eric5512/TrainingVillage/Documentation/main.pdf

# Training village PCBs documentation

2026-03-03

# 1 Introduction

# The system is comprised of three boards. The main one is a raspberry pi shield, seen in fig 1, which exposes three ethernet connectors that go to the other two boards. It also features a DC connector to power the servos and

other peripherals.


Figure 1: 3D render of the Raspberry Pi shield.

# To control the corridor a PCB is designed, this board has connectors to control the motors, the LED strip, the


Figure 2: 3D render of the corridor PCB.

# The behaviour box is controlled from another board that features one connector for a servo and two connectors for LED strips. This board also

allows to connect IR LEDs with a screwed connector.

1


Figure 3: 3D render of the behaviour box PCB.

# 2 Absolute maximum ratings

# Here is presented a table that summarizes the absolute maximum rating of

the system.

Parameter | Value | Units
Input DC jack voltage | 0-6 | V
Output current | 1 | A

# Table 1: Absolute maximum ratings table

2

# 3 Annex

3

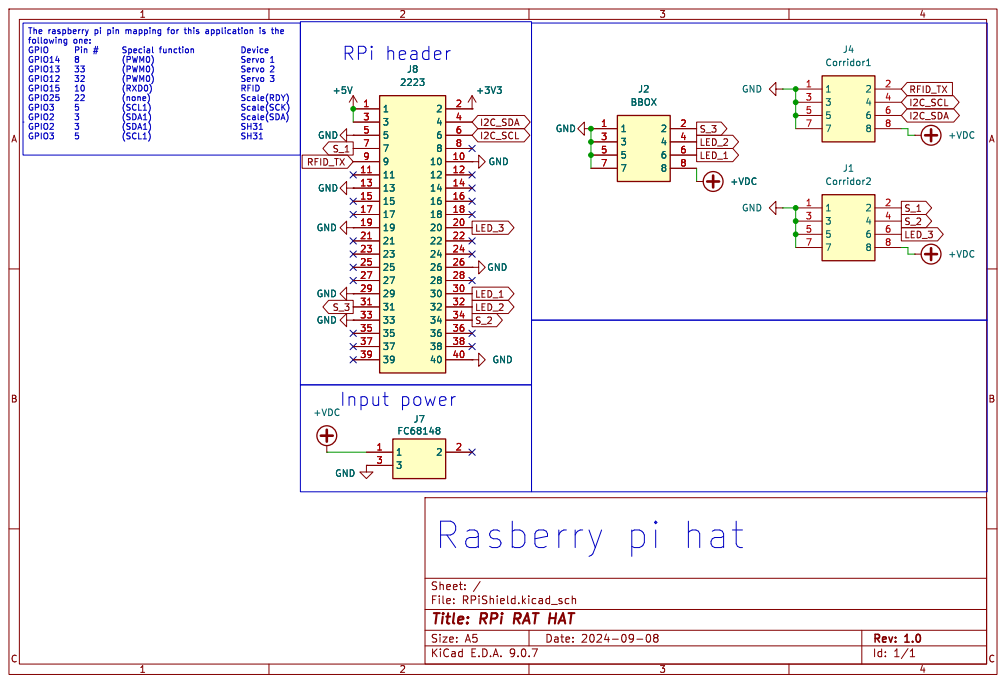
[picture p4: page 5]
Date: 2024-09-08; KiCad; Size: A5; Rev:; File:; RPiShield.kicad_sch; GND; +VDC; J4 Corridor1; J1 Corridor2; J2 BBOX; LED_1; LED_3; I2C_SDA; RFID_TX; I2C_SCL; LED_2; LED_1 RFID_TX; The raspberry; pi pin mapping; for this application; is the; following; one: GPIO Pin; # Special; function Device; GPIO14 8 (PWM0) Servo; 1 GPIO13 33 (PWM0) Servo; 2 GPIO12 32 (PWM0) Servo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

Sheet: /
Title: RPi RAT HAT

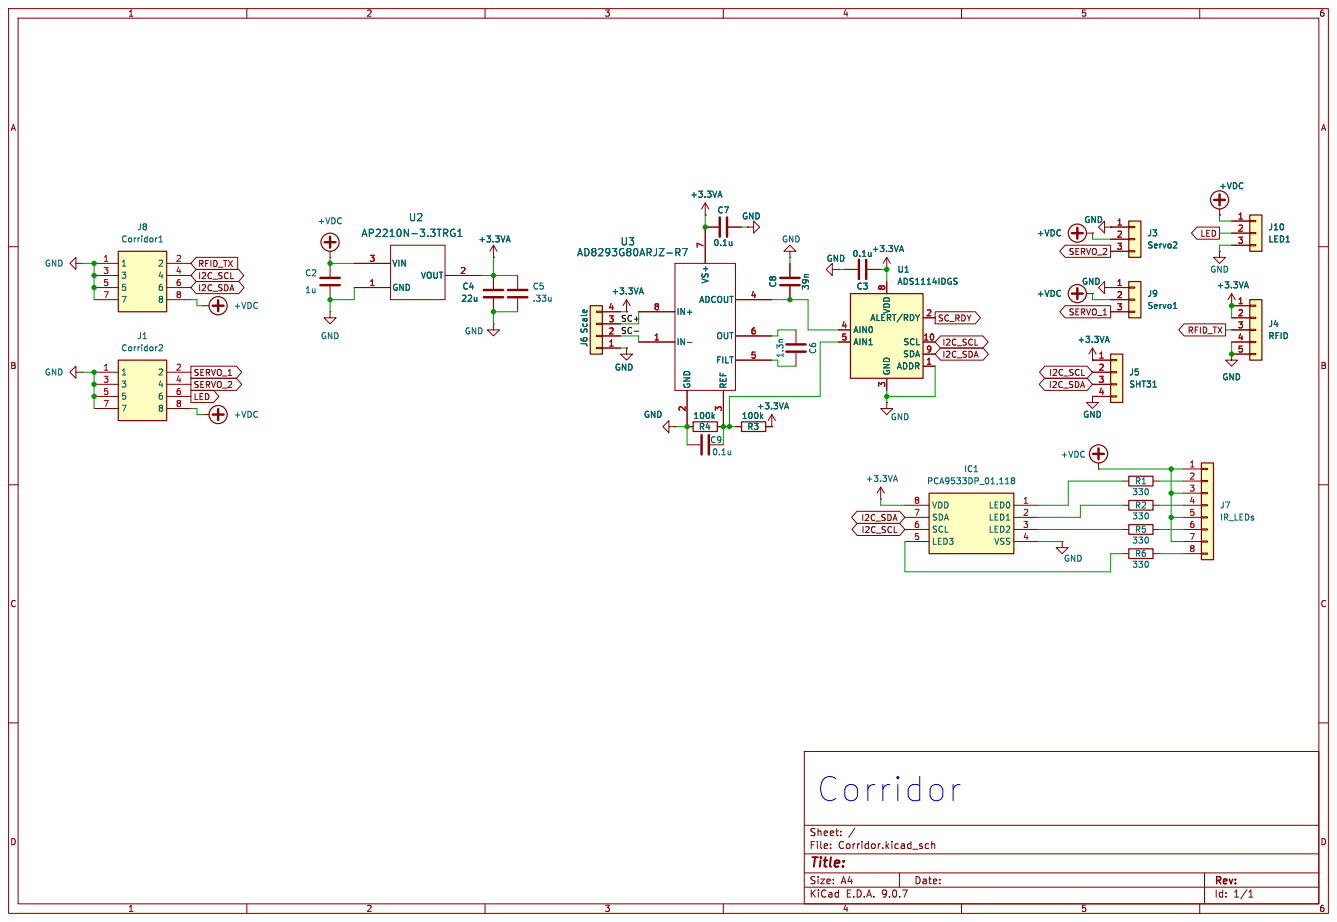
[picture p5: page 6]

3 ADCOUT 4 OUT 6 FILT 5 R4 GND 100k +3.3VA GND

3 ADCOUT 4 OUT 6 FILT 5 U3 AD8293G80ARJZ-R7 GND

3 ALERT/RDY 2 SCL 10 SDA 9 ADDR 1 +3.3VA GND

3 ALERT/RDY 2 SCL 10 SDA 9 ADDR 1 U1ADS1114IDGS

Id: 1/1 Title: File: Corridor.kicad_sch Sheet: /

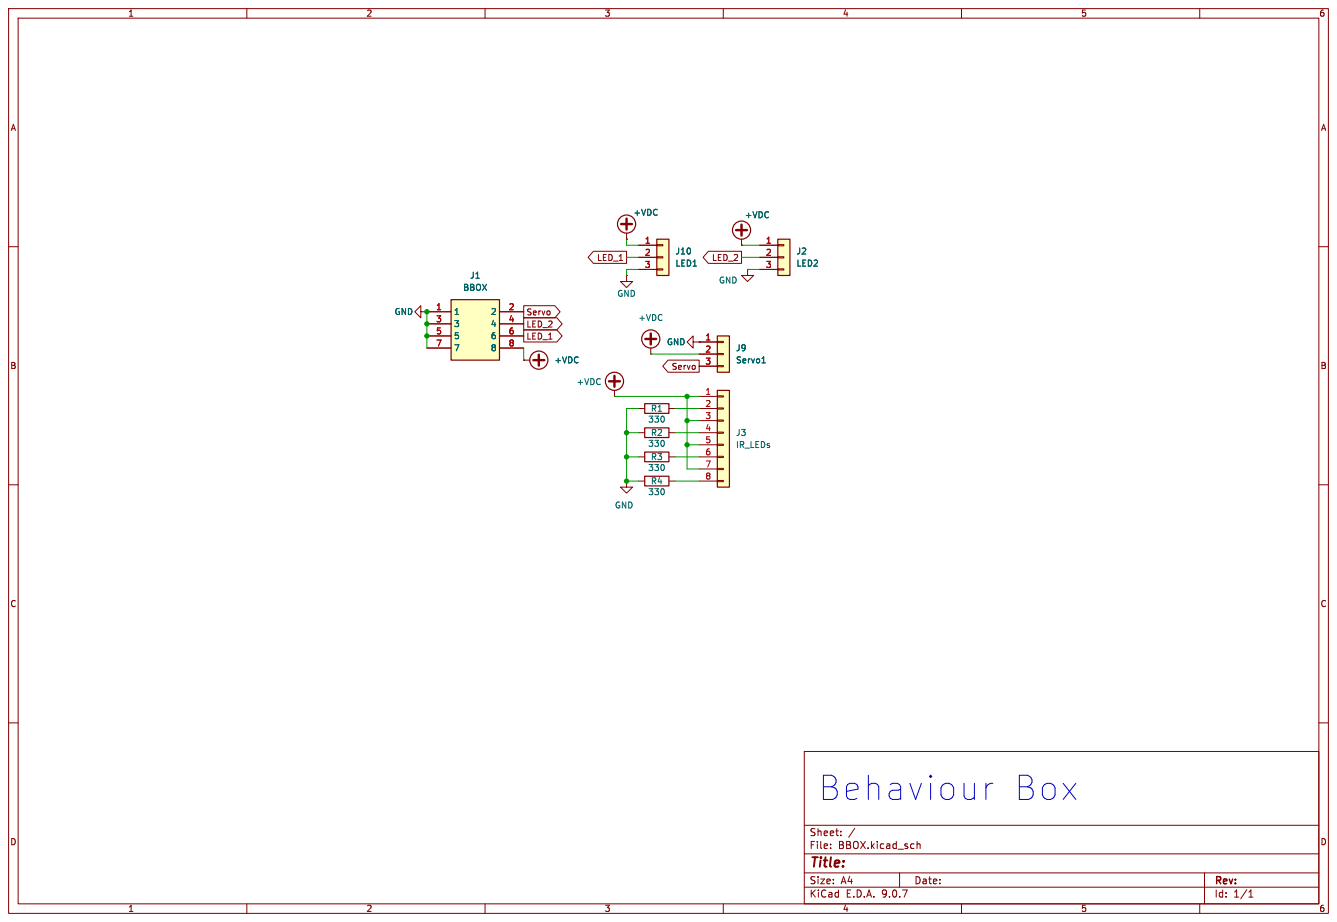
[picture p6: page 7]

Id: 1/1 Title: File: BBOX.kicad_sch Sheet: /
