eric5512/TrainingVillage/BBOX/production_box/production/bom-JLCPCB Assembly Order.xls

JLCPCB BOM Tool - BOM Matching
BOM name：bom-JLCPCB Assembly Order.xlsx |  |  | Download Time：2026-03-19 21:01:40 |  |  |  | * Our matching results are updated in real-time, but stock and prices may change. If it's been over 24 hours, please re-match before placing your order.
PCB Assembled Qty：5 |  |  | Est. Total Price：28.7398
Your BOM |  |  |  |  | Matched Parts |  |  |  |  |  |  | Order Information
Top Designator | Bottom Designator | Comment | Footprint | JLCPCB Part # | Matches | Part # | Manufacturer | Footprint | Description | Category | Warning | JLCPCB Part # | Product link | Lib Type | Qty | Source | Total Price ($)
C2 |  | 1u | 0805 |  | Unconfirmed | CL21B105KBFNNNE | Samsung Electro-Mechanics | 0805 | 1uF 50V X7R ±10% 0805 Multilayer Ceramic Capacitors MLCC - SMD/SMT ROHS | Multilayer Ceramic Capacitors MLCC - SMD/SMT | 1.The comment (CL21B105KBFNNNE) of this part does not match the one (1u) provided in your BOM. Please confirm; | C28323 | https://jlcpcb.com/partdetail/29074-CL21B105KBFNNNE/C28323 | Basic | 5 | 5 JLCPCB | 0.0635
C5 |  | .33u | 0805 |  | Select by Customer | 0805B334K500NT | FH (Guangdong Fenghua Advanced Tech) | 0805 | 330nF 50V X7R ±10% 0805 Multilayer Ceramic Capacitors MLCC - SMD/SMT ROHS | Multilayer Ceramic Capacitors MLCC - SMD/SMT | 1.The comment (0805B334K500NT) of this part does not match the one (.33u) provided in your BOM. Please confirm; | C1740 | https://jlcpcb.com/partdetail/2092-0805B334K500NT/C1740 | Extended | 20 | 20 JLCPCB | 0.31
J1 |  | BBOX | RJ45R08P-A004 |  | Select by Customer | R-RJ45R08P-A004 | Ckmtw(Shenzhen Cankemeng) | 弯插 | 0℃~+70℃ 1 Gold Harpoon Contact (Plastic) Non-LED Phosphor bronze RJ45 Jack Right Angle Unshielded Push-Pull Ethernet Connectors / Modular Connectors (RJ45 RJ11) ROHS | Ethernet Connectors / Modular Connectors (RJ45 RJ11) |  | C385834 | https://jlcpcb.com/partdetail/359709-R_RJ45R08PA004/C385834 | Extended | 5 | 5 JLCPCB | 1.154
J2 |  | WJ127-5.0-2P | WJ127502P |  | Select by Customer | WJ127-5.0-02P-14-00A | Ningbo Kangnex Elec | 插件,P=5mm | -40℃~+105℃ 1 1.5 14~26 15A 1x2P 2 250V 2P 5mm Green Through Hole Plugin,P=5mm Screw Terminal Blocks ROHS | Screw Terminal Blocks |  | C3703 | https://jlcpcb.com/partdetail/4105-WJ127_5_0_02P_1400A/C3703 | Extended | 6 | 6 JLCPCB | 0.9462
J3 |  | Servo2 | PinHeader_1x03_P2.54mm_Vertical |  | Select by Customer | 2.54-1*3P针 | BOOMELE(Boom Precision Elec) | 插件,P=2.54mm | -40℃~+105℃ 1 1x3P 2.54mm 2.5mm 3A 3P 3mm 6mm Black Brass Gold Pin Header Through Hole Plugin,P=2.54mm Pin Headers ROHS | Pin Headers | 1.Multiple lines in the BOM have been matched to the same part. Please check if the matching is correct. ; | C49257 | https://jlcpcb.com/partdetail/50265-2_54_1_3P/C49257 | Extended | 17 | 17 JLCPCB | 0.3451
J9 |  | Servo1 | PinHeader_1x03_P2.54mm_Vertical |  | Select by Customer | 2.54-1*3P针 | BOOMELE(Boom Precision Elec) | 插件,P=2.54mm | -40℃~+105℃ 1 1x3P 2.54mm 2.5mm 3A 3P 3mm 6mm Black Brass Gold Pin Header Through Hole Plugin,P=2.54mm Pin Headers ROHS | Pin Headers | 1.Multiple lines in the BOM have been matched to the same part. Please check if the matching is correct. ; | C49257 | https://jlcpcb.com/partdetail/50265-2_54_1_3P/C49257 | Extended | 17 | 17 JLCPCB | 0.3451
J10 |  | LED | PinHeader_1x03_P2.54mm_Vertical |  | Select by Customer | 2.54-1*3P针 | BOOMELE(Boom Precision Elec) | 插件,P=2.54mm | -40℃~+105℃ 1 1x3P 2.54mm 2.5mm 3A 3P 3mm 6mm Black Brass Gold Pin Header Through Hole Plugin,P=2.54mm Pin Headers ROHS | Pin Headers | 1.Multiple lines in the BOM have been matched to the same part. Please check if the matching is correct. ; | C49257 | https://jlcpcb.com/partdetail/50265-2_54_1_3P/C49257 | Extended | 17 | 17 JLCPCB | 0.3451
J7 |  | IR_LEDs | JL500_8 |  | Select by Customer | JL500-50008GT1 | JILN | 插件,P=5mm | -40℃~+105℃ 1 14~26 15A 1x8P 300V 5mm 8 8P Green M2.5 Through Hole Plugin,P=5mm Screw Terminal Blocks ROHS | Screw Terminal Blocks |  | C2802622 | https://jlcpcb.com/partdetail/JILN-JL50050008GT1/C2802622 | Extended | 5 | 5 JLCPCB | 2.662
Q1 |  | IRLML2502PBF | SOT95P237X112-3N |  | Unconfirmed | IRLML2502PBF-HXY | HXY MOSFET | SOT-23 | -55℃~+150℃ 1 N-channel 1.25W 15nC@4.5V 1V 20V 27mΩ@4.5V 295pF 500pF 96pF 9A N-Channel SOT-23 MOSFETs ROHS | MOSFETs | 1.The comment (IRLML2502PBF-HXY) of this part does not match the one (IRLML2502PBF) provided in your BOM. Please confirm; | C22366704 | https://jlcpcb.com/partdetail/HXYMOSFET-IRLML2502PBFHXY/C22366704 | Extended | 5 | 5 JLCPCB | 0.584
R1,R2,R5,R6 |  | 330 | 1206 |  | Unconfirmed | FRC1206J331 TS | FOJAN | 1206 | -55℃~+155℃ 200V 250mW 330Ω Thick Film Resistor ±100ppm/℃ ±5% 1206 Chip Resistor - Surface Mount ROHS | Chip Resistor - Surface Mount | 1.The comment (FRC1206J331 TS) of this part does not match the one (330) provided in your BOM. Please confirm; | C2907482 | https://jlcpcb.com/partdetail/FOJAN-FRC1206J331TS/C2907482 | Extended | 30 | 30 JLCPCB | 0.084
R7,R8 |  | 4.7k | 0805 |  | Unconfirmed | 0805W8F4701T5E | UNI-ROYAL(Uniroyal Elec) | 0805 | -55℃~+155℃ 125mW 150V 4.7kΩ Thick Film Resistor ±1% ±100ppm/℃ 0805 Chip Resistor - Surface Mount ROHS | Chip Resistor - Surface Mount | 1.The comment (0805W8F4701T5E) of this part does not match the one (4.7k) provided in your BOM. Please confirm; | C17673 | https://jlcpcb.com/partdetail/18361-0805W8F4701T5E/C17673 | Basic | 10 | 10 JLCPCB | 0.019
R9 |  | 10 | 0805 |  | Unconfirmed | 0805W8F100JT5E | UNI-ROYAL(Uniroyal Elec) | 0805 | -55℃~+155℃ 10Ω 125mW 150V Thick Film Resistor ±1% ±200ppm/℃ 0805 Chip Resistor - Surface Mount ROHS | Chip Resistor - Surface Mount | 1.The comment (0805W8F100JT5E) of this part does not match the one (10) provided in your BOM. Please confirm; | C17415 | https://jlcpcb.com/partdetail/18103-0805W8F100JT5E/C17415 | Basic | 5 | 5 JLCPCB | 0.012
U2 |  | AP2210N-3.3TRG1 | SOT_3.3TRG1_DIO |  | Select by System | AP2210N-3.3TRG1 | Diodes Incorporated | SOT-23 | -40℃~+125℃@(Tj) 1 13.2V 1uA 250mV@(300mA) 3.3V 300mA 75dB@(100Hz) Fixed Over Current Protection、Over Temperature Protection Positive SOT-23 Voltage Regulators - Linear, Low Drop Out (LDO) Regulators ROHS | Voltage Regulators - Linear, Low Drop Out (LDO) Regulators |  | C155508 | https://jlcpcb.com/partdetail/DiodesIncorporated-AP2210N_33TRG1/C155508 | Extended | 7 | 7 JLCPCB | 0.8988
U4 |  | PCA9685PW | TSSOP-28_4.4x9.7mm_P0.65mm |  | Unconfirmed | PCA9685PW,118 | NXP Semicon | TSSOP-28 | -40℃~+85℃ 100kHz~1MHz 16 2.3V~5.5V 25mA 5.5V Built-in PWM TSSOP-28 LED Drivers ROHS | LED Drivers | 1.The comment (PCA9685PW,118) of this part does not match the one (PCA9685PW) provided in your BOM. Please confirm; | C2678753 | https://jlcpcb.com/partdetail/NXPSemicon-PCA9685PW118/C2678753 | Extended | 5 | 5 JLCPCB | 18.594
U5 |  | PCA9306 | VSSOP-8_2.3x2mm_P0.5mm |  | Unconfirmed | PCA9306DC1Z | NXP Semicon | VSSOP-8 | -40℃~+105℃ 1 1.8V~5.5V 1V~3.6V 2 2Mbps Auto Direction Detection Bidirectional Open Drain VSSOP-8 Translators, Level Shifters ROHS | Translators, Level Shifters | 1.The comment (PCA9306DC1Z) of this part does not match the one (PCA9306) provided in your BOM. Please confirm; | C5119911 | https://jlcpcb.com/partdetail/NXPSemicon-PCA9306DC1Z/C5119911 | Extended | 5 | 5 JLCPCB | 2.377
C4 |  | 22u | C_Elec_5x5.8 |  | No matches | No Part Selected
