eric5512/TrainingVillage/Corridor/production_corridor/production/bom-JLCPCB Assembly Order.xls

JLCPCB BOM Tool - BOM Matching
BOM name：bom-JLCPCB Assembly Order.xlsx |  |  | Download Time：2026-03-19 20:32:50 |  |  |  | * Our matching results are updated in real-time, but stock and prices may change. If it's been over 24 hours, please re-match before placing your order.
PCB Assembled Qty：5 |  |  | Est. Total Price：122.1937
Your BOM |  |  |  |  | Matched Parts |  |  |  |  |  |  | Order Information
Top Designator | Bottom Designator | Comment | Footprint | JLCPCB Part # | Matches | Part # | Manufacturer | Footprint | Description | Category | Warning | JLCPCB Part # | Product link | Lib Type | Qty | Source | Total Price ($)
C2 |  | 1u | 1206 |  | Unconfirmed | CL31B105KBHNNNE | Samsung Electro-Mechanics | 1206 | 1uF 50V X7R ±10% 1206 Multilayer Ceramic Capacitors MLCC - SMD/SMT ROHS | Multilayer Ceramic Capacitors MLCC - SMD/SMT | 1.The comment (CL31B105KBHNNNE) of this part does not match the one (1u) provided in your BOM. Please confirm; | C1848 | https://jlcpcb.com/partdetail/2200-CL31B105KBHNNNE/C1848 | Basic | 5 | 5 JLCPCB | 0.139
C3,C7,C9 |  | 0.1u | 1206 |  | Unconfirmed | CL31B104KBCNNNC | Samsung Electro-Mechanics | 1206 | 100nF 50V X7R ±10% 1206 Multilayer Ceramic Capacitors MLCC - SMD/SMT ROHS | Multilayer Ceramic Capacitors MLCC - SMD/SMT | 1.The comment (CL31B104KBCNNNC) of this part does not match the one (0.1u) provided in your BOM. Please confirm; | C24497 | https://jlcpcb.com/partdetail/25237-CL31B104KBCNNNC/C24497 | Basic | 15 | 15 JLCPCB | 0.2295
C6 |  | 1.3n | 1206 |  | Select by Customer | 1206B152K500NT | FH (Guangdong Fenghua Advanced Tech) | 1206 | 1.5nF 50V X7R ±10% 1206 Multilayer Ceramic Capacitors MLCC - SMD/SMT ROHS | Multilayer Ceramic Capacitors MLCC - SMD/SMT |  | C1851 | https://jlcpcb.com/partdetail/2203-1206B152K500NT/C1851 | Extended | 15 | 15 JLCPCB | 0.21
C8 |  | 39n | 1206 |  | Unconfirmed | GRM3195C1H393JA01D | Murata Electronics | 1206 | 39nF 50V C0G ±5% 1206 Multilayer Ceramic Capacitors MLCC - SMD/SMT ROHS | Multilayer Ceramic Capacitors MLCC - SMD/SMT | 1.The comment (GRM3195C1H393JA01D) of this part does not match the one (39n) provided in your BOM. Please confirm; | C119053 | https://jlcpcb.com/partdetail/120322-GRM3195C1H393JA01D/C119053 | Extended | 7 | 7 JLCPCB | 0.84
IC2 |  | SHT31-DIS-B2.5KS | SON50P250X250X100-9N-D |  | Select by System | SHT31-DIS-B2.5kS | Sensirion | DFN-8-EP(2.5x2.5) | -40℃~+125℃ 0%RH~100%RH 2.15V~5.5V 600uA I2C ±0.2℃ ±2%RH DFN-8-EP(2.5x2.5) Temperature and Humidity Sensor ROHS | Temperature And Humidity Sensor |  | C80862 | https://jlcpcb.com/partdetail/Sensirion-SHT31_DIS_B25kS/C80862 | Extended | 5 | 5 JLCPCB | 23.7675
J1 |  | WJ127-5.0-2P | WJ127502P |  | Select by Customer | WJ127-5.0-02P-14-00A | Ningbo Kangnex Elec | 插件,P=5mm | -40℃~+105℃ 1 1.5 14~26 15A 1x2P 2 250V 2P 5mm Green Through Hole Plugin,P=5mm Screw Terminal Blocks ROHS | Screw Terminal Blocks |  | C3703 | https://jlcpcb.com/partdetail/4105-WJ127_5_0_02P_1400A/C3703 | Extended | 6 | 6 JLCPCB | 0.9462
J3 |  | Servo2 | PinHeader_1x03_P2.54mm_Vertical |  | Select by Customer | 2.54-1*3P针 | BOOMELE(Boom Precision Elec) | 插件,P=2.54mm | -40℃~+105℃ 1 1x3P 2.54mm 2.5mm 3A 3P 3mm 6mm Black Brass Gold Pin Header Through Hole Plugin,P=2.54mm Pin Headers ROHS | Pin Headers | 1.Multiple lines in the BOM have been matched to the same part. Please check if the matching is correct. ; | C49257 | https://jlcpcb.com/partdetail/50265-2_54_1_3P/C49257 | Extended | 12 | 12 JLCPCB | 0.2436
J9 |  | Servo1 | PinHeader_1x03_P2.54mm_Vertical |  | Select by Customer | 2.54-1*3P针 | BOOMELE(Boom Precision Elec) | 插件,P=2.54mm | -40℃~+105℃ 1 1x3P 2.54mm 2.5mm 3A 3P 3mm 6mm Black Brass Gold Pin Header Through Hole Plugin,P=2.54mm Pin Headers ROHS | Pin Headers | 1.Multiple lines in the BOM have been matched to the same part. Please check if the matching is correct. ; | C49257 | https://jlcpcb.com/partdetail/50265-2_54_1_3P/C49257 | Extended | 12 | 12 JLCPCB | 0.2436
J4 |  | RFID | JST_PH_B5B-PH-K_1x05_P2.00mm_Vertical |  | Select by Customer | B5B-PH-K-S(LF)(SN) | JST | 插件,P=2mm | -25℃~+85℃ 1 100V 11.9mm 1x5P 2A 2mm 4.5mm 5 5P 6mm Brass K Pin PA66 PH Through Hole Tin UL94V-0 White Plugin,P=2mm Wire To Board Connector ROHS | Wire To Board Connector |  | C157993 | https://jlcpcb.com/partdetail/JST-B5B_PH_K_S_LF_SN/C157993 | Extended | 5 | 5 JLCPCB | 0.2655
J6 |  | Scale | JL308-25404G01 |  | Select by Customer | JL308-25404G01 | JILN | 插件,P=2.54mm | -40℃~+105℃ 1 150V 18~26 1x4P 2.54mm 4 4P 6A Green M2.5 Through Hole 插件,P=2.54mm Screw Terminal Blocks ROHS | Screw Terminal Blocks |  | C2922599 | https://jlcpcb.com/partdetail/JILN-JL30825404G01/C2922599 | Extended | 5 | 5 JLCPCB | 2.2265
J7 |  | IR_LEDs | JL500_8 |  | Select by Customer | JL500-50008GT1 | JILN | 插件,P=5mm | -40℃~+105℃ 1 14~26 15A 1x8P 300V 5mm 8 8P Green M2.5 Through Hole Plugin,P=5mm Screw Terminal Blocks ROHS | Screw Terminal Blocks |  | C2802622 | https://jlcpcb.com/partdetail/JILN-JL50050008GT1/C2802622 | Extended | 5 | 5 JLCPCB | 2.662
J8 |  | Corridor1 | RJ45R08P-A004 |  | Select by Customer | R-RJ45R08P-A004 | Ckmtw(Shenzhen Cankemeng) | 弯插 | 0℃~+70℃ 1 Gold Harpoon Contact (Plastic) Non-LED Phosphor bronze RJ45 Jack Right Angle Unshielded Push-Pull Ethernet Connectors / Modular Connectors (RJ45 RJ11) ROHS | Ethernet Connectors / Modular Connectors (RJ45 RJ11) |  | C385834 | https://jlcpcb.com/partdetail/359709-R_RJ45R08PA004/C385834 | Extended | 5 | 5 JLCPCB | 1.154
Q1 |  | IRLML2502PBF | SOT95P237X112-3N |  | Unconfirmed | IRLML2502PBF-HXY | HXY MOSFET | SOT-23 | -55℃~+150℃ 1 N-channel 1.25W 15nC@4.5V 1V 20V 27mΩ@4.5V 295pF 500pF 96pF 9A N-Channel SOT-23 MOSFETs ROHS | MOSFETs | 1.The comment (IRLML2502PBF-HXY) of this part does not match the one (IRLML2502PBF) provided in your BOM. Please confirm; | C22366704 | https://jlcpcb.com/partdetail/HXYMOSFET-IRLML2502PBFHXY/C22366704 | Extended | 5 | 5 JLCPCB | 0.584
R1,R2,R5,R6 |  | 330 | 1206 |  | Unconfirmed | FRC1206J331 TS | FOJAN | 1206 | -55℃~+155℃ 200V 250mW 330Ω Thick Film Resistor ±100ppm/℃ ±5% 1206 Chip Resistor - Surface Mount ROHS | Chip Resistor - Surface Mount | 1.The comment (FRC1206J331 TS) of this part does not match the one (330) provided in your BOM. Please confirm; | C2907482 | https://jlcpcb.com/partdetail/FOJAN-FRC1206J331TS/C2907482 | Extended | 30 | 30 JLCPCB | 0.084
R3,R4 |  | 100k | 1206 |  | Unconfirmed | 1206W4F1003T5E | UNI-ROYAL(Uniroyal Elec) | 1206 | -55℃~+155℃ 100kΩ 200V 250mW Thick Film Resistor ±1% ±100ppm/℃ 1206 Chip Resistor - Surface Mount ROHS | Chip Resistor - Surface Mount | 1.The comment (1206W4F1003T5E) of this part does not match the one (100k) provided in your BOM. Please confirm; | C17900 | https://jlcpcb.com/partdetail/18588-1206W4F1003T5E/C17900 | Basic | 10 | 10 JLCPCB | 0.044
R7,R8 |  | 4.7k | 0805 |  | Unconfirmed | 0805W8F4701T5E | UNI-ROYAL(Uniroyal Elec) | 0805 | -55℃~+155℃ 125mW 150V 4.7kΩ Thick Film Resistor ±1% ±100ppm/℃ 0805 Chip Resistor - Surface Mount ROHS | Chip Resistor - Surface Mount | 1.The comment (0805W8F4701T5E) of this part does not match the one (4.7k) provided in your BOM. Please confirm; | C17673 | https://jlcpcb.com/partdetail/18361-0805W8F4701T5E/C17673 | Basic | 10 | 10 JLCPCB | 0.019
R9 |  | 10 | 1206 |  | Unconfirmed | 1206W4F100JT5E | UNI-ROYAL(Uniroyal Elec) | 1206 | -55℃~+155℃ 10Ω 200V 250mW Thick Film Resistor ±1% ±400ppm/℃ 1206 Chip Resistor - Surface Mount ROHS | Chip Resistor - Surface Mount | 1.The comment (1206W4F100JT5E) of this part does not match the one (10) provided in your BOM. Please confirm; | C17903 | https://jlcpcb.com/partdetail/18591-1206W4F100JT5E/C17903 | Basic | 5 | 5 JLCPCB | 0.0175
U1 |  | ADS1114IDGS | DGS10 |  | Select by Customer | ADS1114IDGSR | Texas Instruments | VSSOP-10 | -40℃~+125℃ 1 150uA 16 1LSB 1MHz 2V~5.5V 6.144V 8Hz 8Hz、16Hz、32Hz、64Hz、128Hz、250Hz、475Hz、860Hz Built-in Built-in I2C Sigma-Delta Support Yes VSSOP-10 Analog to Digital Converters (ADC) ROHS | Analog To Digital Converters (ADC) |  | C174291 | https://jlcpcb.com/partdetail/TexasInstruments-ADS1114IDGSR/C174291 | Extended | 5 | 5 JLCPCB | 20.068
U2 |  | AP2210N-3.3TRG1 | SOT_3.3TRG1_DIO |  | Select by System | AP2210N-3.3TRG1 | Diodes Incorporated | SOT-23 | -40℃~+125℃@(Tj) 1 13.2V 1uA 250mV@(300mA) 3.3V 300mA 75dB@(100Hz) Fixed Over Current Protection、Over Temperature Protection Positive SOT-23 Voltage Regulators - Linear, Low Drop Out (LDO) Regulators ROHS | Voltage Regulators - Linear, Low Drop Out (LDO) Regulators |  | C155508 | https://jlcpcb.com/partdetail/DiodesIncorporated-AP2210N_33TRG1/C155508 | Extended | 7 | 7 JLCPCB | 0.8988
U3 |  | AD8293G80ARJZ-R7 | RJ_8_ADI |  | Select by System | AD8293G80ARJZ-R7 | Analog Devices | SOT-23-8 | -40℃~+85℃ 1 1.8V~5.5V 1.9ms 120dB 140dB 1mA 20nV/℃ 35mA 35nV/√Hz@1kHz 400pA 4nA 5.5V 9uV Rail-to-Rail Output SOT-23-8 Instrumentation Amplifiers ROHS | Instrumentation Amplifiers |  | C578677 | https://jlcpcb.com/partdetail/AnalogDevices-AD8293G80ARJZR7/C578677 | Extended | 5 | 5 JLCPCB | 42.7895
U4 |  | PCA9685PW | TSSOP-28_4.4x9.7mm_P0.65mm |  | Unconfirmed | PCA9685PW,118 | NXP Semicon | TSSOP-28 | -40℃~+85℃ 100kHz~1MHz 16 2.3V~5.5V 25mA 5.5V Built-in PWM TSSOP-28 LED Drivers ROHS | LED Drivers | 1.The comment (PCA9685PW,118) of this part does not match the one (PCA9685PW) provided in your BOM. Please confirm; | C2678753 | https://jlcpcb.com/partdetail/NXPSemicon-PCA9685PW118/C2678753 | Extended | 5 | 5 JLCPCB | 18.594
U5 |  | PCA9306 | VSSOP-8_2.3x2mm_P0.5mm |  | Unconfirmed | PCA9306DC1Z | NXP Semicon | VSSOP-8 | -40℃~+105℃ 1 1.8V~5.5V 1V~3.6V 2 2Mbps Auto Direction Detection Bidirectional Open Drain VSSOP-8 Translators, Level Shifters ROHS | Translators, Level Shifters | 1.The comment (PCA9306DC1Z) of this part does not match the one (PCA9306) provided in your BOM. Please confirm; | C5119911 | https://jlcpcb.com/partdetail/NXPSemicon-PCA9306DC1Z/C5119911 | Extended | 5 | 5 JLCPCB | 2.377
