eric5512/TrainingVillage/RPiShield/LIB_2223/2223.stp

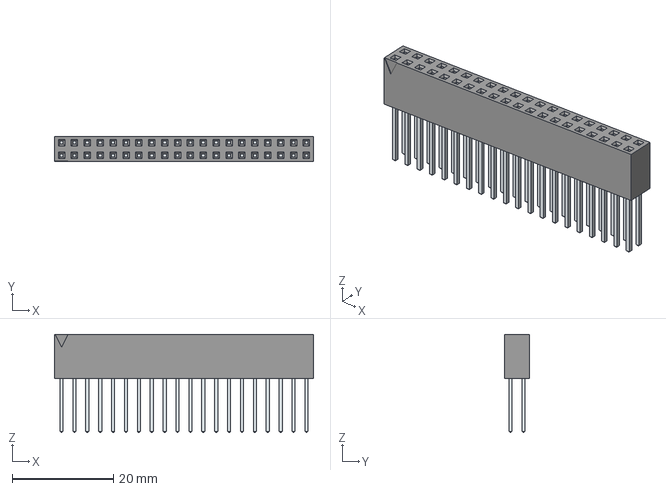
[picture p7: CAD file, 2026-03-18]
RPiShield/LIB_2223/2223.stp
51.1 x 5.00 x 19.4 mm
LeadsArray
