eric5512/TrainingVillage/RPiShield/LIB_05200101Z/05200101Z.stp

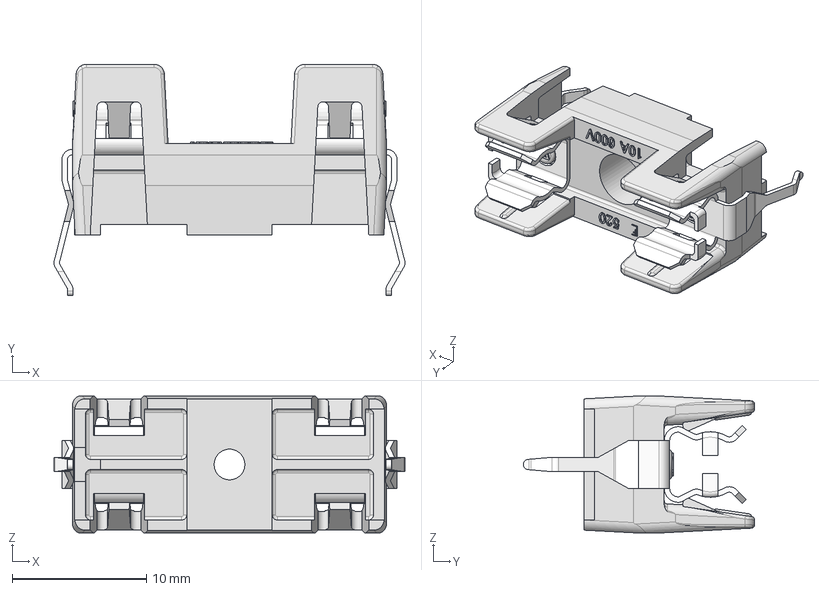
[picture p8: CAD file, 2026-03-20]
RPiShield/LIB_05200101Z/05200101Z.stp
26.1 x 17.2 x 10.2 mm
111509_MIR
