eric5512/TrainingVillage/RPiShield/LIB_FC68148/FC68148.stp

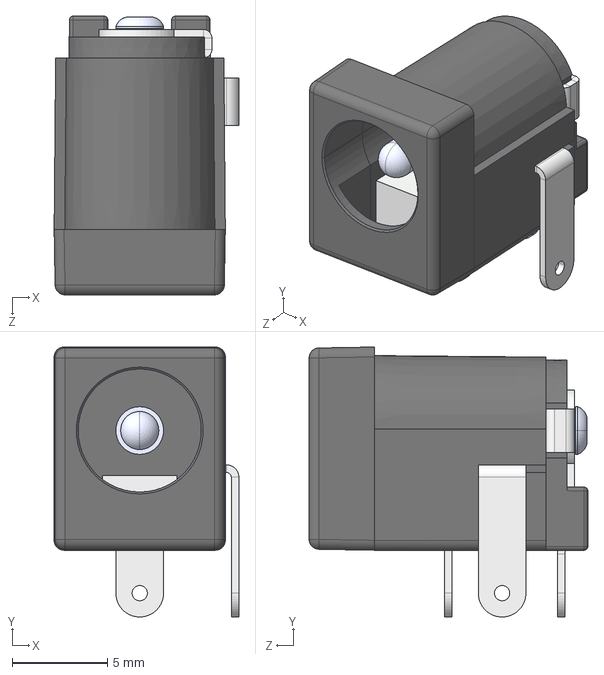
[picture p9: CAD file, 2026-03-18]
RPiShield/LIB_FC68148/FC68148.stp
9.69 x 14.2 x 14.6 mm
