eric5512/TrainingVillage/RPiShield/LIB_RJE031880416/RJE031880416--3DModel-STEP-533217.STEP

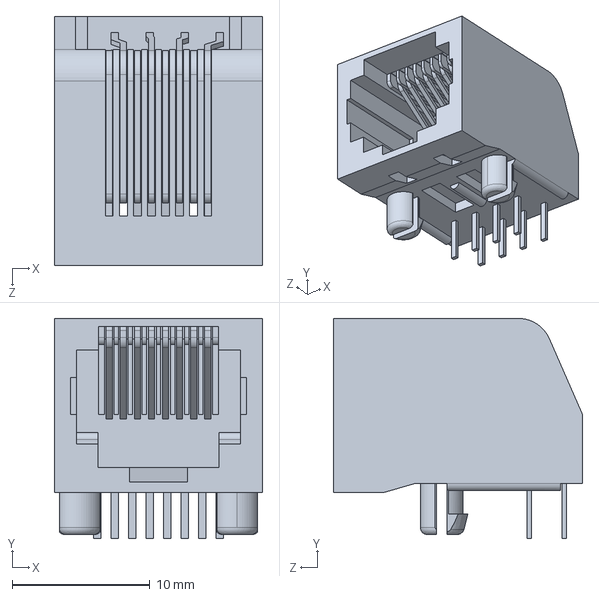
[picture p10: CAD file, 2026-03-18]
RPiShield/LIB_RJE031880416/RJE031880416--3DModel-STEP-533217.STEP
15.1 x 16.0 x 18.1 mm
