eric5512/TrainingVillage/Documentation/BBOX.pdf

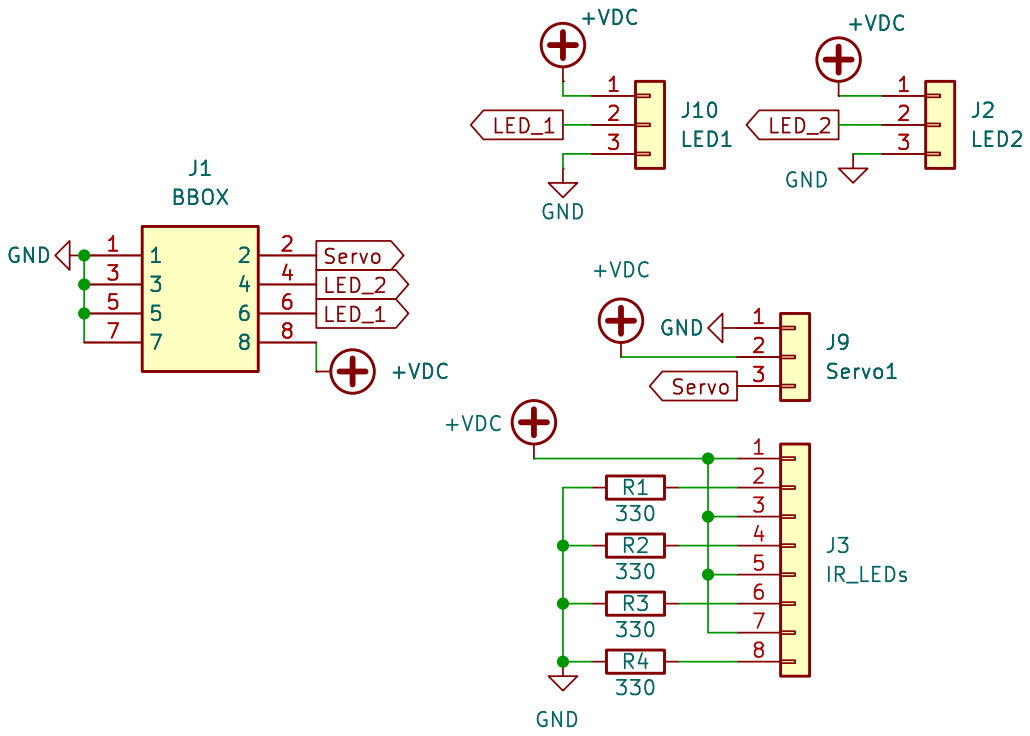
[picture p11: page 1]

Id: 1/1 Title: File: BBOX.kicad_sch Sheet: /
