eric5512/TrainingVillage/Documentation/RPiShield.pdf

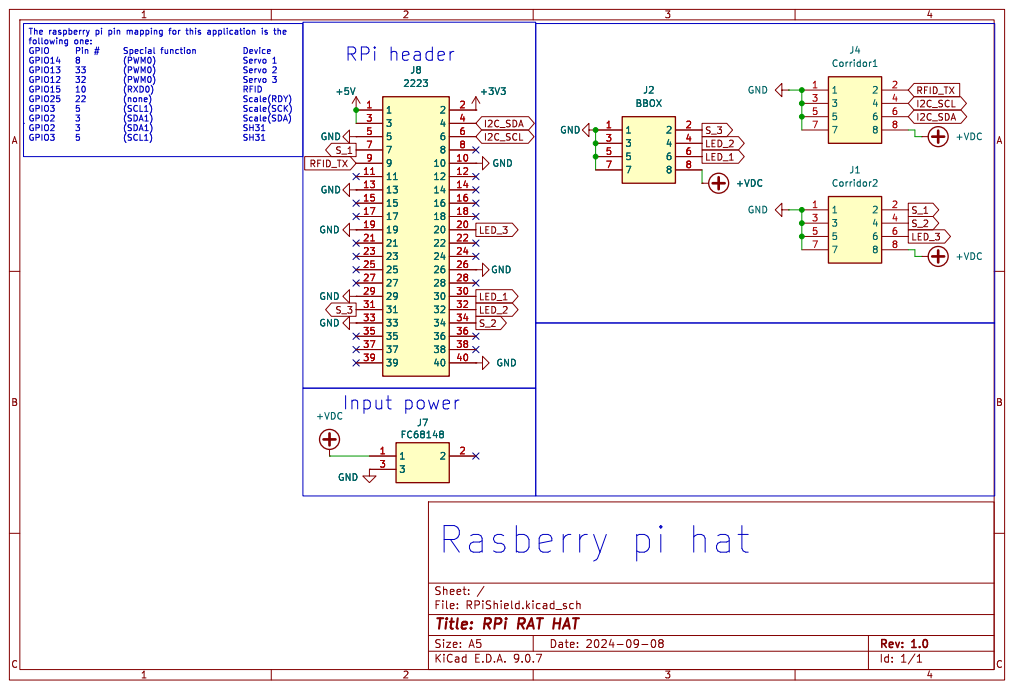
[picture p12: page 1]

RPi header J4 J8 J8

3 3 | 4 4
5 5 | 6 6

Sheet: /
Title: RPi RAT HAT
