eric5512/TrainingVillage/Corridor/Corridor.kicad_pcb

## KiCad design Corridor/Corridor.kicad_pcb (2026-08-27)

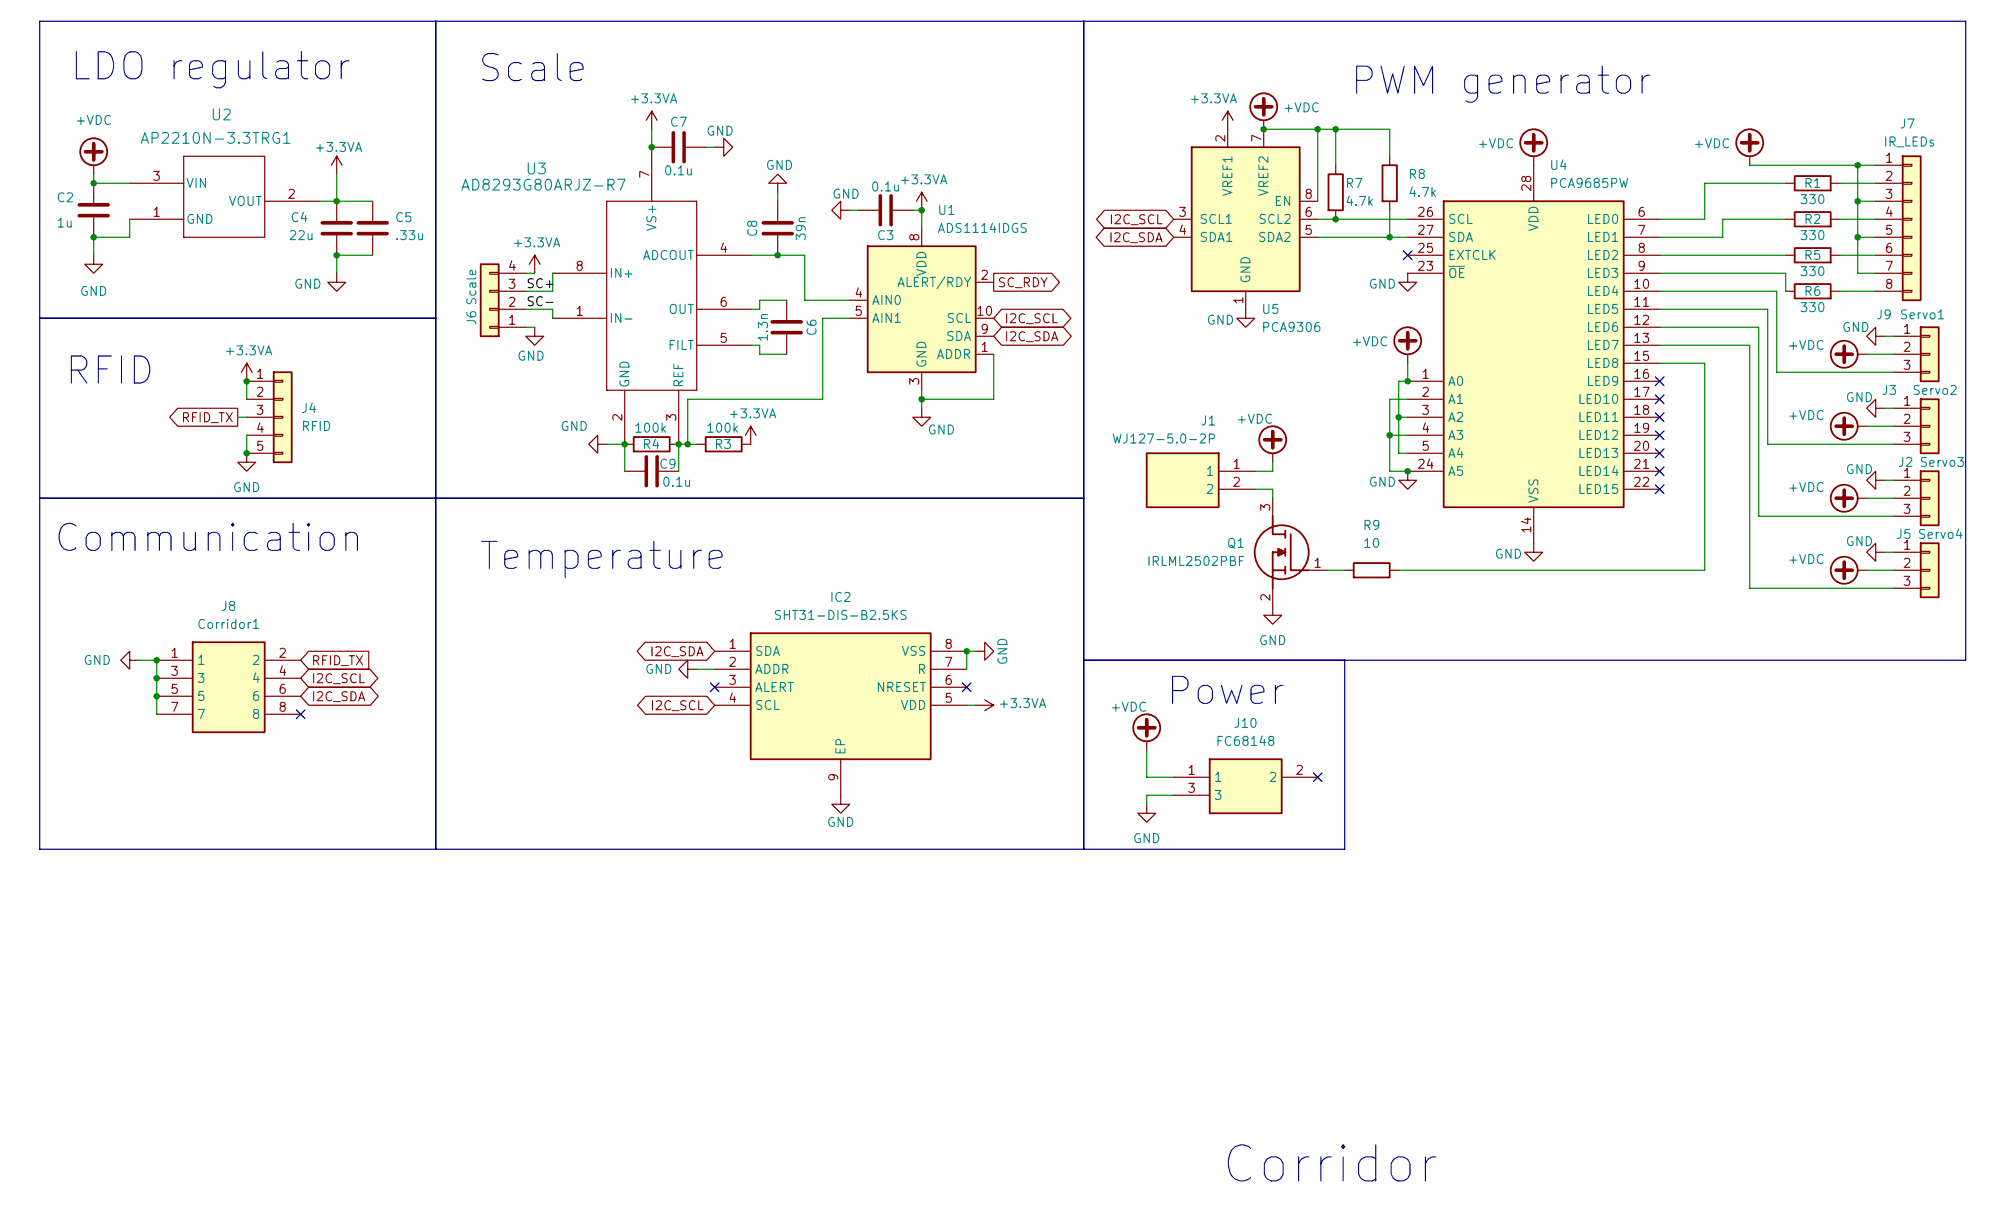
[picture p13: schematic Corridor.kicad_sch]

Parts:
C2: 1u; C_1206_3216Metric_Pad1.33x1.80mm_HandSolder
C3, C7, C9: 0.1u; C_1206_3216Metric_Pad1.33x1.80mm_HandSolder
C4: 22u; C_Elec_5x5.8
C5: .33u; C_1206_3216Metric_Pad1.33x1.80mm_HandSolder
C6: 1.3n; C_1206_3216Metric_Pad1.33x1.80mm_HandSolder
C8: 39n; C_1206_3216Metric_Pad1.33x1.80mm_HandSolder
IC2: SHT31-DIS-B2.5KS; SON50P250X250X100-9N-D; Manufacturer_Part_Number SHT31-DIS-B2.5KS; Mouser Part Number 403-SHT31-DIS-B
J1: WJ127-5.0-2P; WJ127502P; Manufacturer_Part_Number WJ127-5.0-2P
J2: Servo3; PinHeader_1x03_P2.54mm_Vertical
J3: Servo2; PinHeader_1x03_P2.54mm_Vertical
J4: RFID; JST_PH_B5B-PH-K_1x05_P2.00mm_Vertical
J5: Servo4; PinHeader_1x03_P2.54mm_Vertical
J6: Scale; JL308-25404G01
J7: IR_LEDs; JL500_8
J8: Corridor1; RJ45R08P-A004; Manufacturer_Part_Number RJ45R08P-A004
J9: Servo1; PinHeader_1x03_P2.54mm_Vertical
J10: FC68148; Manufacturer_Part_Number FC68148
Q1: IRLML2502PBF; SOT95P237X112-3N; Manufacturer_Part_Number IRLML2502PBF; Mouser Part Number N/A
R1, R2, R5, R6: 330; R_1206_3216Metric
R3, R4: 100k; R_1206_3216Metric_Pad1.30x1.75mm_HandSolder
R7, R8: 4.7k; R_0805_2012Metric
R9: 10; R_1206_3216Metric
U1: ADS1114IDGS; DGS10
U2: AP2210N-3.3TRG1; SOT_3.3TRG1_DIO
U3: AD8293G80ARJZ-R7; RJ_8_ADI
U4: PCA9685PW; TSSOP-28_4.4x9.7mm_P0.65mm
U5: PCA9306; VSSOP-8_2.3x2mm_P0.5mm

Connections:
+3.3VA: C3.2, C4.1, C5.1, C7.2, IC2.5 (VDD), J4.1, J4.2, J6.4, R3.1, U1.8 (VDD), U2.2 (VOUT), U3.7 (VS+), U5.2 (VREF1)
+VDC: C2.1, J1.1, J2.2, J3.2, J5.2, J7.1, J7.3, J7.5, J7.7, J9.2, J10.1, R7.1, R8.1, U2.3 (VIN), U4.1 (A0), U4.3 (A2), U4.5 (A4), U4.28 (VDD), U5.7 (VREF2), U5.8 (EN)
/SC+: J6.3, U3.8 (IN+)
/SC-: J6.2, U3.1 (IN-)
GND: C2.2, C3.1, C4.2, C5.2, C7.1, C8.1, C9.2, IC2.2 (ADDR), IC2.7 (R), IC2.8 (VSS), IC2.9 (EP), J2.1, J3.1, J4.4, J4.5, J5.1, J6.1, J8.1, J8.3, J8.5, J8.7, J9.1, J10.3, Q1.2 (S), R4.2, U1.1 (ADDR), U1.3 (GND), U2.1 (GND), U3.2 (GND), U4.2 (A1), U4.4 (A3), U4.14 (VSS), U4.23 (~OE), U4.24 (A5), U5.1 (GND)
I2C_SCL: IC2.4 (SCL), J8.4, U1.10 (SCL), U5.3 (SCL1)
I2C_SDA: IC2.1 (SDA), J8.6, U1.9 (SDA), U5.4 (SDA1)
unnamed: J2.3, U4.12 (LED6)
unnamed: J3.3, U4.11 (LED5)
unnamed: J5.3, U4.13 (LED7)
unnamed: J7.2, R1.2
unnamed: J7.4, R2.2
unnamed: J7.6, R5.2
unnamed: J7.8, R6.2
unnamed: J9.3, U4.10 (LED4)
unnamed: J1.2, Q1.3 (D)
unnamed: Q1.1 (G), R9.2
unnamed: C8.2, U1.4 (AIN0), U3.4 (ADCOUT)
unnamed: C9.1, R3.2, R4.1, U1.5 (AIN1), U3.3 (REF)
unnamed: C6.1, U3.5 (FILT)
unnamed: C6.2, U3.6 (OUT)
unnamed: R1.1, U4.6 (LED0)
unnamed: R2.1, U4.7 (LED1)
unnamed: R5.1, U4.8 (LED2)
unnamed: R6.1, U4.9 (LED3)
unnamed: R9.1, U4.15 (LED8)
unnamed: R7.2, U4.26 (SCL), U5.6 (SCL2)
unnamed: R8.2, U4.27 (SDA), U5.5 (SDA2)
RFID_TX: J4.3, J8.2
SC_RDY: U1.2 (ALERT/RDY)

Notes on the sheet:
RFID
Scale
Corridor
LDO regulator
Power
Communication
PWM generator
Temperature

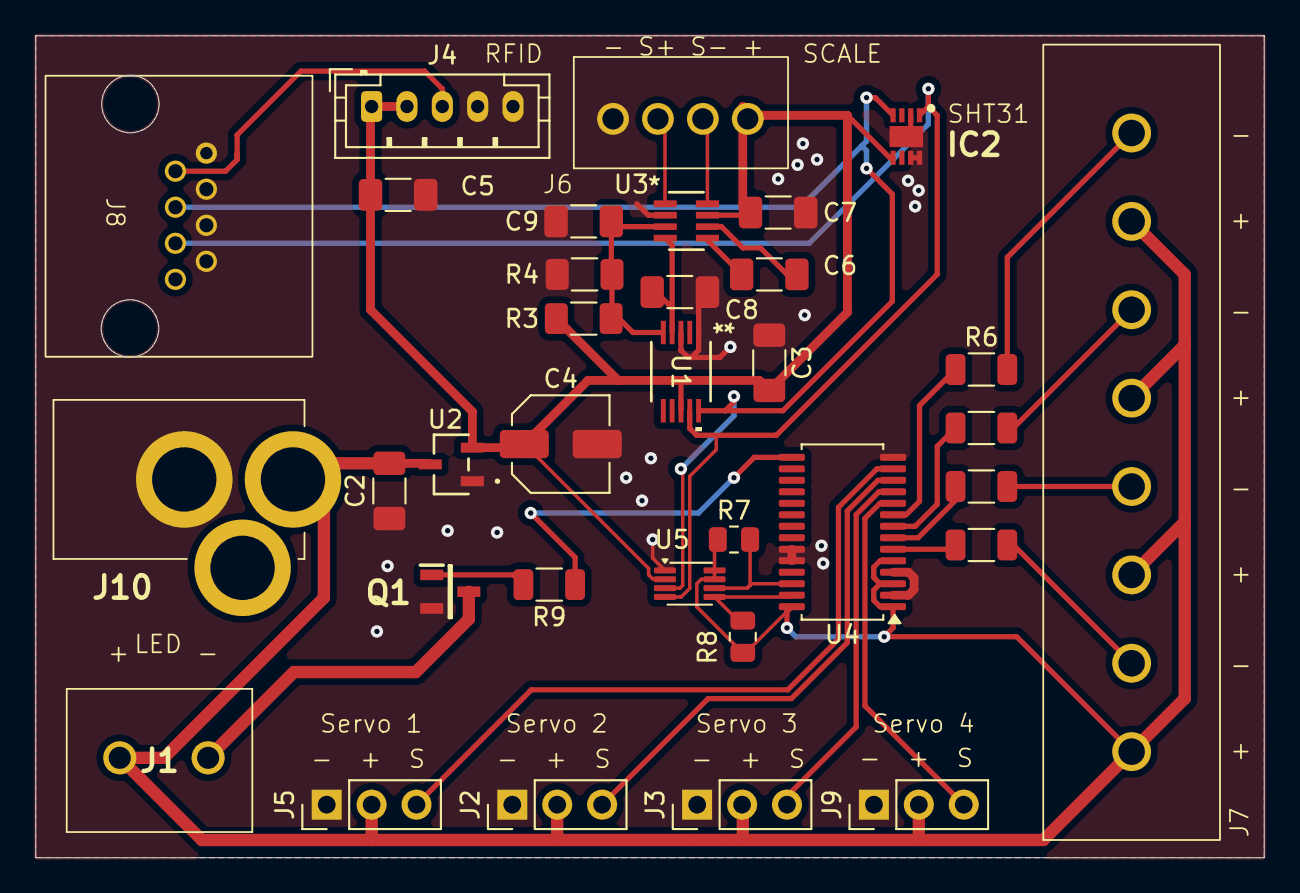
[picture p14: board Corridor.kicad_pcb from above]

Board: 2 copper layers, 69.5 x 46.5 mm, 34 parts (0 on the bottom side), 29 nets.
