eric5512/TrainingVillage/RPiShield/RPiShield.kicad_pcb

## KiCad design RPiShield/RPiShield.kicad_pcb (2026-08-27)

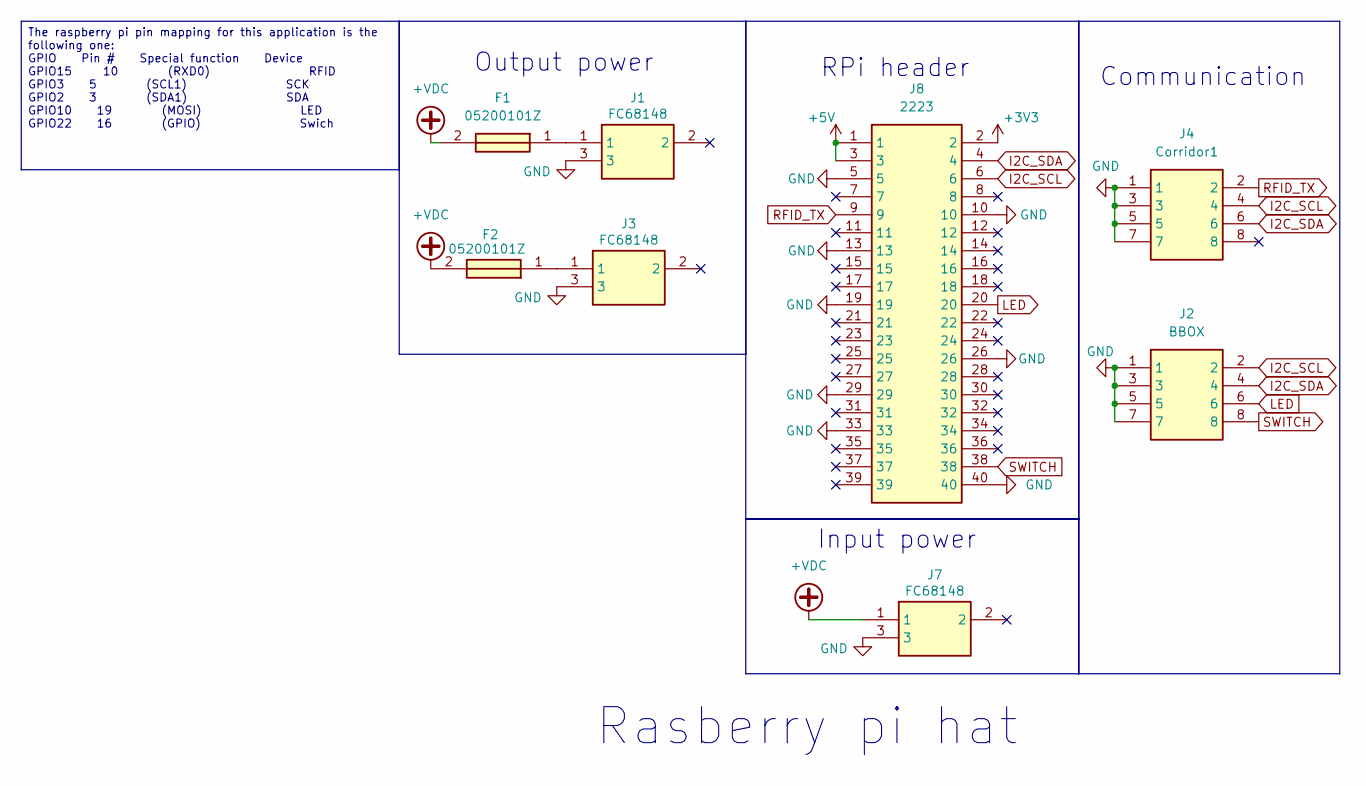
[picture p15: schematic RPiShield.kicad_sch, RPi RAT HAT]

Parts:
F1, F2: 05200101Z; Manufacturer_Part_Number 05200101Z; Mouser Part Number 576-05200101Z
J1, J3, J7: FC68148; Manufacturer_Part_Number FC68148
J2: BBOX; RJ45R08P-A004; Manufacturer_Part_Number RJE031880416
J4: Corridor1; RJ45R08P-A004; Manufacturer_Part_Number RJE031880416
J8: 2223; RHDR40W64P254X254_2X20_5105X500X865P; Manufacturer_Part_Number 2223

Connections:
+3V3: J8.2
+5V: J8.1, J8.3
+VDC: F1.2, F2.2, J7.1
GND: J1.3, J2.1, J2.3, J2.5, J2.7, J3.3, J4.1, J4.3, J4.5, J4.7, J7.3, J8.5, J8.10, J8.13, J8.19, J8.26, J8.29, J8.33, J8.40
I2C_SCL: J2.2, J4.4, J8.6
I2C_SDA: J2.4, J4.6, J8.4
LED: J2.6, J8.20
unnamed: F1.1, J1.1
unnamed: F2.1, J3.1
RFID_TX: J4.2, J8.9
SWITCH: J2.8, J8.38

Notes on the sheet:
Input power
Communication
Rasberry pi hat
RPi header
Output power
The raspberry pi pin mapping for this application is the following one: GPIO Pin # Special function Device GPIO15 10 (RXD0) RFID GPIO3 5 (SCL1) SCK GPIO2 3 (SDA1) SDA GPIO10 19 (MOSI) LED GPIO22 16 (GPIO) Swich

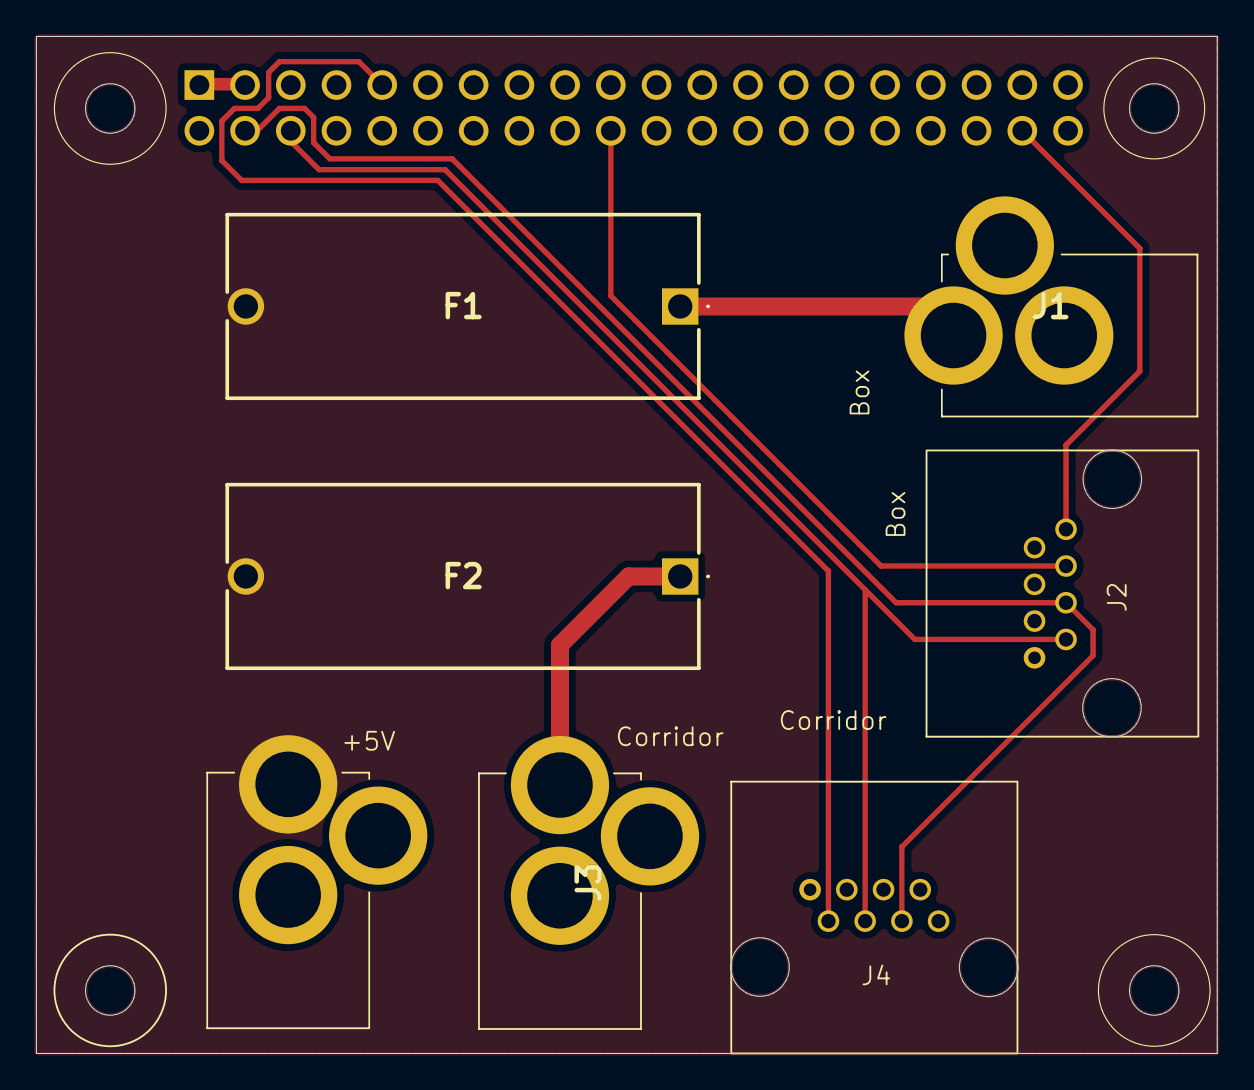
[picture p16: board RPiShield.kicad_pcb from above]

Board: 2 copper layers, 65.6 x 56.5 mm, 8 parts (1 on the bottom side), 10 nets.
