eric5512/TrainingVillage/(commit log)

2026-03-18 Creating repo for training village circuits
    [2223.stp, BBOX.kicad_pcb, BBOX.kicad_sch, Corridor.kicad_pcb, Corridor.kicad_sch, FC68148.stp, RJE031880416--3DModel-STEP-533217.STEP, RPiShield.kicad_pcb]
2026-03-20 Adding fuseholder to the HAT
    [05200101Z.stp, BBOX.kicad_pcb, Corridor.kicad_pcb, RPiShield.kicad_pcb, RPiShield.kicad_sch, bom-JLCPCB Assembly Order.xls]
2026-04-10 New TrainingVillage version
    [RPiShield.kicad_sch, bom-JLCPCB Assembly Order.xls]
